CullenLab/NeuropixelsSYNC/(commit log)

2025-04-16 Create circuit folder
2025-04-16 Added schematic files
    [SYNC_circuit.sch]
2025-04-16 added Arduino sketch source code
2025-06-17 Add files via upload
    Cleaned up Arduino code.
